ssfivy/smartdcdc/(list of files, drawings)

Other design files:
hardware/3V3-CAN.SchDoc
hardware/3V-Switcher-50mA.SCHDOC
hardware/12to5VSwitcher-3A.SCHDOC
hardware/120-12V-DCDC.SCHDOC
hardware/AuxBattery.SCHDOC
hardware/CAN_Switch.SCHDOC
hardware/CANConnectors.SCHDOC
hardware/endpanel_highvoltage.PcbDoc
hardware/endpanel_lowvoltage.PcbDoc
hardware/Isolated3V3.SCHDOC
hardware/IsolatedADC-OLD.SCHDOC
hardware/IsolatedADC.SCHDOC
hardware/MSP430F149.SCHDOC
hardware/Precharge.SCHDOC
hardware/Smart_DCDC.PCBLIB
hardware/Smart_DCDC.PRJPCB
hardware/Smart_DCDC.SCHLIB
hardware/Smart_DCDC_v5.PCBDOC
hardware/TopLevel.SCHDOC
