ssfivy/smartdcdc/software/other_spi.h

u08 init_spi0();
u08 spi0_select_device(u08	device);
void spi0_deselect_all();
u08 spi0_transfer(u08 out_data);

u08 init_spi2();
u08 spi2_select_device(u08	device);
void spi2_deselect_all();
u08 spi2_transfer(u08 out_data);
